aviralverma-8877/esp32-ioptron_smart_eq_controller/ESP32-EasyEDA/20261004_115152.jpg

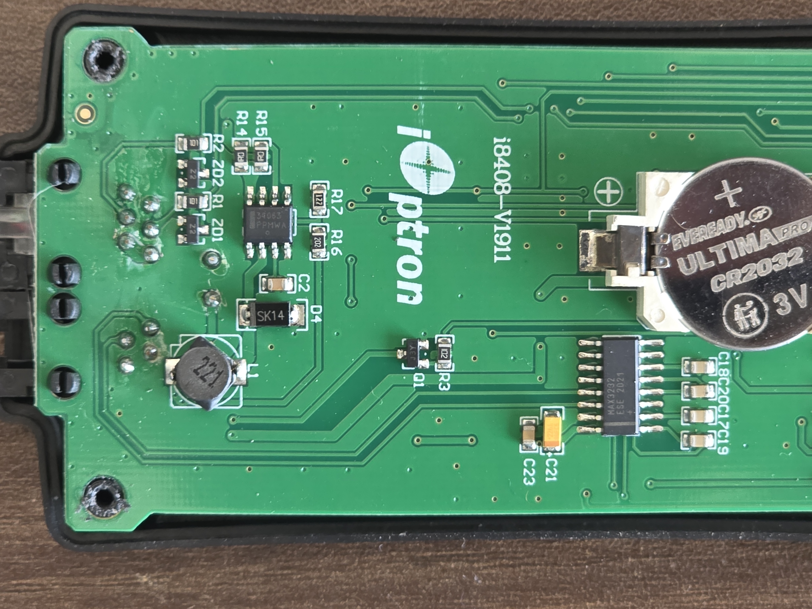
ESP32-EasyEDA/20261004_115152.jpg
