aviralverma-8877/esp32-ioptron_smart_eq_controller/tools/sdcard/catalog.csv

# SmartEQ sky catalog v1 - key | label | name | type | con | mag | size_arcmin | ra_hours_j2000 | dec_deg_j2000
M001 | M1 | Crab Nebula | SN remnant | Tau | 8.4 | 8.0 | 5.575547 | 22.01447
M002 | M2 | NGC 7089 | Globular | Aqr | 6.2 | 8.4 | 21.557503 | -0.82331
M003 | M3 | NGC 5272 | Globular | CVn | 6.4 | 16.2 | 13.703119 | 28.37544
M004 | M4 | NGC 6121 | Globular | Sco | 5.4 | 28.2 | 16.393167 | -26.52553
M005 | M5 | NGC 5904 | Globular | Se1 | 6.0 | 15.0 | 15.309375 | 2.08269
M006 | M6 | Butterfly Cluster | Open cl. | Sco | 4.2 | 15.6 | 17.672431 | -32.25417
M007 | M7 | Ptolemy's Cluster | Open cl. | Sco | 3.3 | 22.2 | 17.897550 | -34.79283
M008 | M8 | Lagoon Nebula | Nebula | Sgr | 5.8 | 45.0 | 18.061464 | -24.38017
M009 | M9 | NGC 6333 | Globular | Oph | 8.4 | 6.9 | 17.319939 | -18.51625
M010 | M10 | NGC 6254 | Globular | Oph | 5.0 | 9.3 | 16.952497 | -4.09933
M011 | M11 | Amas de l'Ecu de Sobieski | Open cl. | Sct | 5.8 | 9.0 | 18.851664 | -6.27003
M012 | M12 | NGC 6218 | Globular | Oph | 6.1 | 11.1 | 16.787367 | -1.94783
M013 | M13 | Hercules Globular Cluster | Globular | Her | 5.8 | 16.5 | 16.694897 | 36.46131
M014 | M14 | NGC 6402 | Globular | Oph | 5.7 | 9.9 | 17.626711 | -3.24592
M015 | M15 | NGC 7078 | Globular | Peg | 6.3 | 11.1 | 21.499550 | 12.16683
M016 | M16 | Eagle Nebula | Nebula | Se2 | 6.0 | 120.0 | 18.313381 | -13.80722
M017 | M17 | Checkmark Nebula | Nebula | Sgr | 7.0 | 12.6 | 18.346419 | -16.17153
M018 | M18 | NGC 6613 | Open cl. | Sgr | 6.9 | 6.0 | 18.332914 | -17.10197
M019 | M19 | NGC 6273 | Globular | Oph | 5.6 | 7.5 | 17.043800 | -26.26794
M020 | M20 | Trifid Nebula | Nebula | Sgr | 8.5 | 28.0 | 18.045031 | -22.97189
M021 | M21 | NGC 6531 | Open cl. | Sgr | 5.9 | 6.0 | 18.070403 | -22.49006
M022 | M22 | NGC 6656 | Globular | Sgr | 5.1 | 12.6 | 18.606722 | -23.90342
M023 | M23 | NGC 6494 | Open cl. | Sgr | 5.5 | 16.8 | 17.951325 | -18.98533
M024 | M24 | Small Sgr Star Cloud | Star cloud | Sgr | 4.5 | 120.0 | 18.282256 | -18.51456
M025 | M25 | IC 4725 | Open cl. | Sgr | 4.6 | 14.1 | 18.529658 | -19.11494
M026 | M26 | NGC 6694 | Open cl. | Sct | 8.9 | 6.0 | 18.755183 | -9.38361
M027 | M27 | Dumbbell Nebula | Planetary | Vul | 7.4 | 6.7 | 19.993439 | 22.72103
M028 | M28 | NGC 6626 | Globular | Sgr | 6.9 | 5.1 | 18.409136 | -24.86983
M029 | M29 | NGC 6913 | Open cl. | Cyg | 6.6 | 3.6 | 20.399381 | 38.50767
M030 | M30 | NGC 7099 | Globular | Cap | 7.1 | 9.0 | 21.672783 | -23.17908
M031 | M31 | Andromeda Galaxy | Galaxy | And | 3.4 | 177.8 | 0.712319 | 41.26906
M032 | M32 | NGC 221 | Galaxy | And | 8.1 | 7.7 | 0.711619 | 40.86528
M033 | M33 | Triangulum Galaxy | Galaxy | Tri | 5.8 | 62.1 | 1.564136 | 30.66022
M034 | M34 | NGC 1039 | Open cl. | Per | 5.2 | 22.5 | 2.702056 | 42.74614
M035 | M35 | NGC 2168 | Open cl. | Gem | 5.3 | 24.0 | 6.151406 | 24.33864
M036 | M36 | NGC 1960 | Open cl. | Aur | 6.0 | 7.2 | 5.604928 | 34.14075
M037 | M37 | NGC 2099 | Open cl. | Aur | 5.6 | 11.4 | 5.871764 | 32.55300
M038 | M38 | NGC 1912 | Open cl. | Aur | 6.4 | 9.6 | 5.478469 | 35.85492
M039 | M39 | NGC 7092 | Open cl. | Cyg | 4.6 | 19.5 | 21.530089 | 48.43817
M040 | M40 | Winnecke 4 | Double | UMa | 8.0 |  | 12.371139 | 58.08444
M041 | M41 | NGC 2287 | Open cl. | CMa | 4.5 | 12.0 | 6.766650 | -20.75422
M042 | M42 | Great Orion Nebula | Cl+Nebula | Ori | 4.0 | 90.0 | 5.587911 | -5.38967
M043 | M43 | Mairan's Nebula | Nebula | Ori | 9.0 | 20.0 | 5.592050 | -5.26747
M044 | M44 | Beehive | Open cl. | Cnc | 3.1 | 108.6 | 8.672833 | 19.67206
M045 | M45 | Pleiades | Open cl. | Tau | 1.2 | 150.0 | 3.791278 | 24.10528
M046 | M46 | NGC 2437 | Open cl. | Pup | 6.1 | 21.0 | 7.696339 | -14.81000
M047 | M47 | NGC 2422 | Open cl. | Pup | 4.4 | 19.8 | 7.609728 | -14.48261
M048 | M48 | NGC 2548 | Open cl. | Hya | 5.8 | 28.2 | 8.228661 | -5.75044
M049 | M49 | NGC 4472 | Galaxy | Vir | 8.3 | 10.2 | 12.496322 | 8.00047
M050 | M50 | NGC 2323 | Open cl. | Mon | 5.9 | 14.1 | 7.044575 | -8.36403
M051 | M51 | Whirlpool Galaxy | Galaxy | CVn | 8.4 | 13.7 | 13.497975 | 47.19517
M052 | M52 | NGC 7654 | Open cl. | Cas | 6.9 | 9.9 | 23.413444 | 61.59317
M053 | M53 | NGC 5024 | Globular | Com | 7.8 | 9.0 | 13.215342 | 18.16911
M054 | M54 | NGC 6715 | Globular | Sgr | 7.7 | 5.1 | 18.917575 | -30.47850
M055 | M55 | NGC 6809 | Globular | Sgr | 6.5 | 12.0 | 19.666500 | -30.96208
M056 | M56 | NGC 6779 | Globular | Lyr | 8.4 | 5.8 | 19.276531 | 30.18450
M057 | M57 | Ring Nebula | Planetary | Lyr | 8.8 | 1.3 | 18.893058 | 33.02858
M058 | M58 | NGC 4579 | Galaxy | Vir | 10.3 | 5.0 | 12.628756 | 11.81819
M059 | M59 | NGC 4621 | Galaxy | Vir | 9.6 | 4.5 | 12.700622 | 11.64703
M060 | M60 | NGC 4649 | Galaxy | Vir | 8.8 | 6.8 | 12.727772 | 11.55269
M061 | M61 | NGC 4303 | Galaxy | Vir | 10.2 | 6.9 | 12.365250 | 4.47364
M062 | M62 | NGC 6266 | Globular | Oph | 6.5 | 7.8 | 17.020167 | -30.11236
M063 | M63 | Sunflower Galaxy | Galaxy | CVn | 8.6 | 11.8 | 13.263703 | 42.02928
M064 | M64 | Black Eye Galaxy | Galaxy | Com | 8.5 | 10.5 | 12.945456 | 21.68297
M065 | M65 | NGC 3623 | Galaxy | Leo | 9.3 | 7.6 | 11.315533 | 13.09236
M066 | M66 | NGC 3627 | Galaxy | Leo | 8.9 | 10.3 | 11.337489 | 12.99153
M067 | M67 | NGC 2682 | Open cl. | Cnc | 6.9 | 33.0 | 8.855592 | 11.81194
M068 | M68 | NGC 4590 | Globular | Hya | 8.0 | 6.6 | 12.657781 | -26.74303
M069 | M69 | NGC 6637 | Globular | Sgr | 7.6 | 5.7 | 18.523119 | -32.34797
M070 | M70 | NGC 6681 | Globular | Sgr | 7.9 | 6.6 | 18.720178 | -32.29189
M071 | M71 | NGC 6838 | Globular | Sge | 8.2 | 6.9 | 19.896142 | 18.77839
M072 | M72 | NGC 6981 | Globular | Aqr | 9.0 | 4.5 | 20.891086 | -12.53706
M073 | M73 | NGC 6994 | Asterism | Aqr | 8.9 |  | 20.982214 | -12.63550
M074 | M74 | NGC 628 | Galaxy | Psc | 9.3 | 9.9 | 1.611597 | 15.78367
M075 | M75 | NGC 6864 | Globular | Sgr | 8.3 | 3.6 | 20.101344 | -21.92222
M076 | M76 | Barbell Nebula | Planetary | Per | 10.1 | 1.1 | 1.705469 | 51.57547
M077 | M77 | NGC 1068 | Galaxy | Cet | 9.3 | 6.1 | 2.711308 | -0.01328
M078 | M78 | NGC 2068 | Nebula | Ori | 8.0 | 4.5 | 5.779394 | 0.07931
M079 | M79 | NGC 1904 | Globular | Lep | 8.2 | 7.2 | 5.402942 | -24.52422
M080 | M80 | NGC 6093 | Globular | Sco | 7.3 | 5.7 | 16.284031 | -22.97511
M081 | M81 | Bode's Galaxy | Galaxy | UMa | 6.9 | 21.6 | 9.925881 | 69.06531
M082 | M82 | Cigar Galaxy | Galaxy | UMa | 8.3 | 11.0 | 9.931314 | 69.67939
M083 | M83 | Southern Pinwheel Galaxy | Galaxy | Hya | 7.2 | 13.6 | 13.616931 | -29.86542
M084 | M84 | NGC 4374 | Galaxy | Vir | 9.8 | 7.4 | 12.417706 | 12.88697
M085 | M85 | NGC 4382 | Galaxy | Com | 9.1 | 7.0 | 12.423364 | 18.19150
M086 | M86 | NGC 4406 | Galaxy | Vir | 8.9 | 11.5 | 12.436594 | 12.94622
M087 | M87 | Virgo Galaxy | Galaxy | Vir | 9.0 | 7.1 | 12.513728 | 12.39111
M088 | M88 | NGC 4501 | Galaxy | Com | 10.3 | 8.7 | 12.533100 | 14.42039
M089 | M89 | NGC 4552 | Galaxy | Vir | 10.1 | 8.1 | 12.594392 | 12.55633
M090 | M90 | NGC 4569 | Galaxy | Vir | 9.5 | 9.1 | 12.613831 | 13.16294
M091 | M91 | NGC 4548 | Galaxy | Com | 11.0 | 5.5 | 12.590681 | 14.49633
M092 | M92 | NGC 6341 | Globular | Her | 6.5 | 14.4 | 17.285353 | 43.13653
M093 | M93 | NGC 2447 | Open cl. | Pup | 6.2 | 15.0 | 7.741453 | -23.85308
M094 | M94 | NGC 4736 | Galaxy | CVn | 8.2 | 7.7 | 12.848072 | 41.12044
M095 | M95 | NGC 3351 | Galaxy | Leo | 9.8 | 7.2 | 10.732694 | 11.70381
M096 | M96 | NGC 3368 | Galaxy | Leo | 9.2 | 8.3 | 10.779372 | 11.81994
M097 | M97 | Owl Nebula | Planetary | UMa | 9.9 | 3.6 | 11.246586 | 55.01903
M098 | M98 | NGC 4192 | Galaxy | Com | 10.8 | 11.0 | 12.230081 | 14.90033
M099 | M99 | Coma Pinwheel | Galaxy | Com | 9.8 | 5.0 | 12.313778 | 14.41650
M100 | M100 | NGC 4321 | Galaxy | Com | 9.5 | 6.1 | 12.381897 | 15.82181
M101 | M101 | NGC 5457 | Galaxy | UMa | 7.9 | 24.0 | 14.053483 | 54.34894
M102 | M102 | Spindle Galaxy | Galaxy | Dra | 9.9 | 6.3 | 15.108194 | 55.76322
M103 | M103 | NGC 581 | Open cl. | Cas | 7.4 | 4.5 | 1.556058 | 60.65800
M104 | M104 | Sombrero Galaxy | Galaxy | Vir | 8.6 | 8.4 | 12.666508 | -11.62306
M105 | M105 | NGC 3379 | Galaxy | Leo | 9.3 | 4.9 | 10.797108 | 12.58161
M106 | M106 | NGC 4258 | Galaxy | CVn | 9.3 | 17.0 | 12.315972 | 47.30397
M107 | M107 | NGC 6171 | Globular | Oph | 7.9 | 7.8 | 16.542200 | -13.05364
M108 | M108 | NGC 3556 | Galaxy | UMa | 10.1 | 4.0 | 11.191936 | 55.67411
M109 | M109 | NGC 3992 | Galaxy | UMa | 9.9 | 8.1 | 11.959994 | 53.37453
M110 | M110 | NGC 205 | Galaxy | And | 8.2 | 16.2 | 0.672800 | 41.68531
S001 | Sirius | alf CMa | Star | CMa | -1.46 |  | 6.752197 | -16.72512
S002 | Canopus | alf Car | Star | Car | -0.74 |  | 6.399213 | -52.69549
S003 | Arcturus | alf Boo | Star | Boo | -0.05 |  | 14.260452 | 19.16769
S004 | Vega | alf Lyr | Star | Lyr | 0.03 |  | 18.615775 | 38.78580
S005 | Capella | alf Aur | Star | Aur | 0.08 |  | 5.278208 | 45.99485
S006 | Rigel | bet Ori | Star | Ori | 0.13 |  | 5.242298 | -8.20163
S007 | Procyon | alf CMi | Star | CMi | 0.34 |  | 7.654681 | 5.21736
S008 | Achernar | alf Eri | Star | Eri | 0.46 |  | 1.628647 | -57.23703
S009 | Betelgeuse | alf Ori | Star | Ori | 0.50 |  | 5.919543 | 7.40715
S010 | Hadar | bet Cen | Star | Cen | 0.61 |  | 14.063691 | -60.37321
S011 | Altair | alf Aql | Star | Aql | 0.76 |  | 19.846655 | 8.87116
S012 | Acrux | alf Cru | Star | Cru | 0.76 |  | 12.443265 | -63.09920
S013 | Aldebaran | alf Tau | Star | Tau | 0.86 |  | 4.598710 | 16.50791
S014 | Antares | alf Sco | Star | Sco | 0.96 |  | 16.490121 | -26.43217
S015 | Spica | alf Vir | Star | Vir | 0.97 |  | 13.419862 | -11.16155
S016 | Pollux | bet Gem | Star | Gem | 1.14 |  | 7.754916 | 28.02586
S017 | Fomalhaut | alf PsA | Star | PsA | 1.16 |  | 22.961032 | -29.62345
S018 | Deneb | alf Cyg | Star | Cyg | 1.25 |  | 20.690533 | 45.28035
S019 | Mimosa | bet Cru | Star | Cru | 1.25 |  | 12.795311 | -59.68889
S020 | Regulus | alf Leo | Star | Leo | 1.35 |  | 10.139406 | 11.96725
S021 | Adhara | eps CMa | Star | CMa | 1.50 |  | 6.977099 | -28.97208
S022 | Castor | alf Gem | Star | Gem | 1.58 |  | 7.576521 | 31.88721
S023 | Shaula | lam Sco | Star | Sco | 1.62 |  | 17.560139 | -37.10405
S024 | Gacrux | gam Cru | Star | Cru | 1.64 |  | 12.519459 | -57.11516
S025 | Bellatrix | gam Ori | Star | Ori | 1.64 |  | 5.418847 | 6.34961
S026 | Elnath | bet Tau | Star | Tau | 1.65 |  | 5.438211 | 28.60617
S027 | Miaplacidus | bet Car | Star | Car | 1.67 |  | 9.219772 | -69.71641
S028 | Alnilam | eps Ori | Star | Ori | 1.69 |  | 5.603560 | -1.20192
S029 | Alnair | alf Gru | Star | Gru | 1.73 |  | 22.137309 | -46.96206
S030 | Alnitak | zet Ori | Star | Ori | 1.77 |  | 5.679315 | -1.94256
S031 | Alioth | eps UMa | Star | UMa | 1.77 |  | 12.900584 | 55.95976
S032 | Dubhe | alf UMa | Star | UMa | 1.79 |  | 11.061992 | 61.75078
S033 | Mirfak | alf Per | Star | Per | 1.79 |  | 3.405399 | 49.86099
S034 | Wezen | del CMa | Star | CMa | 1.83 |  | 7.139855 | -26.39318
S035 | Kaus Australis | eps Sgr | Star | Sgr | 1.85 |  | 18.402843 | -34.38553
S036 | Alkaid | eta UMa | Star | UMa | 1.86 |  | 13.792253 | 49.31316
S037 | Sargas | the Sco | Star | Sco | 1.86 |  | 17.621984 | -42.99785
S038 | Menkalinan | bet Aur | Star | Aur | 1.90 |  | 5.992106 | 44.94743
S039 | Atria | alf TrA | Star | TrA | 1.91 |  | 16.811107 | -69.02794
S040 | Alhena | gam Gem | Star | Gem | 1.93 |  | 6.628538 | 16.39888
S041 | Peacock | alf Pav | Star | Pav | 1.94 |  | 20.427466 | -56.73572
S042 | Polaris | alf UMi | Star | UMi | 1.98 |  | 2.532004 | 89.26402
S043 | Mirzam | bet CMa | Star | CMa | 1.98 |  | 6.378328 | -17.95592
S044 | Alphard | alf Hya | Star | Hya | 1.98 |  | 9.459782 | -8.65835
S045 | Hamal | alf Ari | Star | Ari | 2.00 |  | 2.119658 | 23.46133
S046 | Algieba | gam Leo | Star | Leo | 2.01 |  | 10.333034 | 19.84035
S047 | Diphda | bet Cet | Star | Cet | 2.02 |  | 0.726612 | -17.98637
S048 | Nunki | sig Sgr | Star | Sgr | 2.05 |  | 18.921099 | -26.29712
S049 | Mirach | bet And | Star | And | 2.05 |  | 1.162307 | 35.61973
S050 | Alpheratz | alf And | Star | And | 2.06 |  | 0.139872 | 29.08923
S051 | Rasalhague | alf Oph | Star | Oph | 2.07 |  | 17.582296 | 12.55841
S052 | Kochab | bet UMi | Star | UMi | 2.08 |  | 14.845032 | 74.15559
S053 | Saiph | kap Ori | Star | Ori | 2.09 |  | 5.795942 | -9.66961
S054 | Almach | gam And | Star | And | 2.10 |  | 2.065015 | 42.32937
S055 | Algol | bet Per | Star | Per | 2.12 |  | 3.136150 | 40.95563
S056 | Denebola | bet Leo | Star | Leo | 2.13 |  | 11.817408 | 14.57121
S057 | Mizar | zet UMa | Star | UMa | 2.23 |  | 13.398863 | 54.92516
S058 | Schedar | alf Cas | Star | Cas | 2.24 |  | 0.675167 | 56.53710
S059 | Caph | bet Cas | Star | Cas | 2.28 |  | 0.153469 | 59.14846
S060 | Albireo | bet Cyg | Star | Cyg | 3.05 |  | 19.512024 | 27.95959
P001 | Mercury | Innermost planet | Planet |  | 0.0
P002 | Venus | Evening/morning star | Planet |  | -4.2
P003 | Mars | The red planet | Planet |  | 0.5
P004 | Jupiter | Gas giant | Planet |  | -2.3
P005 | Saturn | Ringed planet | Planet |  | 0.6
P006 | Uranus | Ice giant | Planet |  | 5.7
P007 | Neptune | Ice giant | Planet |  | 7.8
P008 | Moon | Earth's Moon | Moon |  | -12.7
