aviralverma-8877/esp32-ioptron_smart_eq_controller/cad-shell/Top (With SD Card).stl

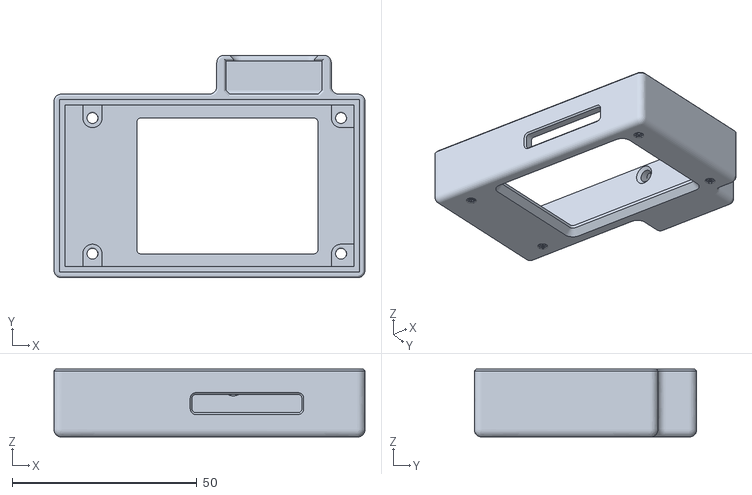
[picture p2: CAD file, 2026-10-21]
cad-shell/Top (With SD Card).stl
84.2 x 60.2 x 18.4
