aviralverma-8877/esp32-ioptron_smart_eq_controller/cad-shell/Bottom.stl

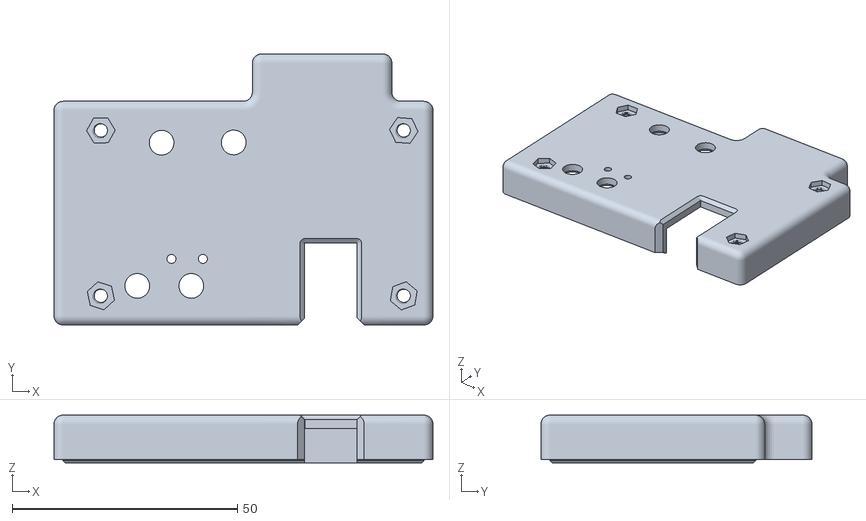
[picture p3: CAD file, 2026-10-21]
cad-shell/Bottom.stl
84.2 x 60.2 x 10.6
