aviralverma-8877/esp32-ioptron_smart_eq_controller/cad-shell/Buttons.stl

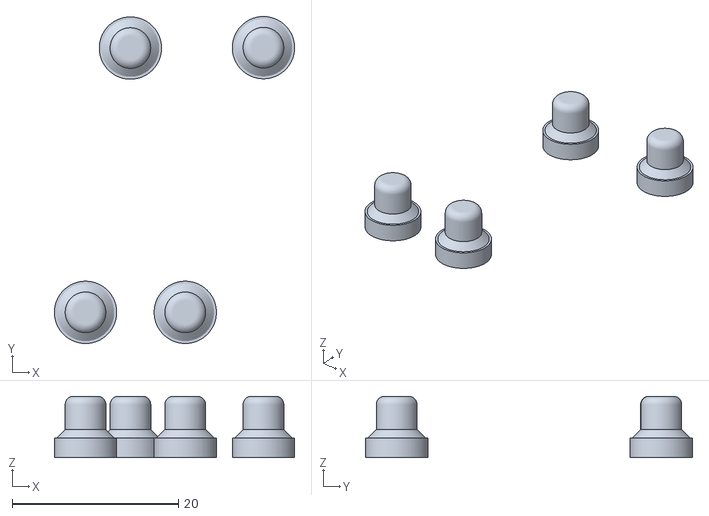
[picture p4: CAD file, 2026-10-17]
cad-shell/Buttons.stl
28.9 x 39.3 x 7.40
