aviralverma-8877/esp32-ioptron_smart_eq_controller/(list of files, cad)

Other CAD files:
cad-shell/Top.stl
