aviralverma-8877/esp32-ioptron_smart_eq_controller/src/display.cpp

// display.cpp - ST7789 status page (mount / GPS / SD). Redraws only changed fields;
// ui.cpp owns the screen and calls displayTick() only while this page is shown.
#include "display.h"
#include "config.h"
#include "mount.h"
#include "bt_bridge.h"
#include "gps.h"
#include "gps_sync.h"
#include "message.h"
#include "sky.h"
#include "xlate.h"
#include <SPI.h>
#include <esp32/rom/crc.h>
#include <Adafruit_GFX.h>
#include <Adafruit_ST7789.h>
#include <string.h>

Adafruit_ST7789 tft(TFT_CS, TFT_DC, TFT_RST);
static const int SCR_W = 320;

struct Row { int16_t y; uint8_t sz; const char *label; char cache[34]; };
static Row rows[] = {
  {  30, 1, "Model", "" }, {  42, 1, "FW",    "" },
  {  56, 2, "Time",  "" }, {  78, 2, "Date",  "" },
  { 100, 1, "Zone",  "" }, { 112, 2, "Site",  "" },
  { 136, 2, "Stat",  "" }, { 158, 1, "Trk",   "" }, { 170, 1, "Pos", "" },
};
enum { R_MODEL, R_FW, R_TIME, R_DATE, R_ZONE, R_SITE, R_STAT, R_TRK, R_POS };
static char hdrCache[48] = "", gpsCache[40] = "", fixCache[40] = "", ftrCache[40] = "";

static void txt(int x, int y, const char *s, uint16_t fg, uint8_t sz, uint16_t bg = BG) {
  tft.setTextSize(sz); tft.setTextColor(fg, bg); tft.setCursor(x, y); tft.print(s);
}

static void staticLayout() {
  tft.fillScreen(BG);
  tft.drawFastHLine(0, 26, SCR_W, C_HEAD);
  tft.drawFastHLine(0, 52, SCR_W, C_SEP);
  tft.drawFastHLine(0, 132, SCR_W, C_SEP);
  tft.drawFastHLine(0, 186, SCR_W, C_SEP);
  for (auto &r : rows) txt(4, r.y + (r.sz == 2 ? 2 : 0), r.label, C_LBL, 1);
}

static void row(int i, const char *val, uint16_t color) {
  Row &r = rows[i];
  int w = r.sz == 2 ? 13 : 8;                 // pad width in chars
  char pad[40];
  snprintf(pad, sizeof pad, "%-*.*s", 26 - w, 26 - w, val);
  if (!strcmp(r.cache, pad)) return;
  strncpy(r.cache, pad, sizeof r.cache - 1);
  txt(w * 6 + 6, r.y, pad, color, r.sz);
}

static void header() {
  const char *st0 = btConnected ? "BRIDGE" : (linkUp ? "MOUNT OK" : "NO MOUNT");
  char st[24];
  if (xlateMode() == XL_NATIVE) snprintf(st, sizeof st, "%s", st0);
  else snprintf(st, sizeof st, "%s  %s", st0, xlateModeName(xlateMode()));   // BT client protocol
  bool sd = skyReady();
  char h[48];
  snprintf(h, sizeof h, "%s|%s|%d", BT_NAME, st, sd);
  if (strcmp(h, hdrCache)) {
    strncpy(hdrCache, h, sizeof hdrCache - 1);
    tft.fillRect(0, 2, SCR_W, 22, BG);
    txt(4, 4, BT_NAME, C_HEAD, 2);
    txt(4 + 12 * 12, 8, st, btConnected ? C_WARN : (linkUp ? C_OK : C_BAD), 1);
    if (sd) {                                  // catalog badge ("SD" / "FS")
      tft.fillRoundRect(SCR_W - 26, 5, 22, 15, 3, C_OK);
      txt(SCR_W - 21, 9, SKY_BADGE, BG, 1, C_OK);
    }
  }
}

static void gpsBlock() {
  char s[40], line[40];
  gpsStatusStr(s, sizeof s);
  bool lk = gpsLocked();
  snprintf(line, sizeof line, "GPS: %-18s", s);
  if (strcmp(line, gpsCache)) {
    strncpy(gpsCache, line, sizeof gpsCache - 1);
    tft.fillRect(0, 192, SCR_W, 18, BG);
    txt(4, 192, "GPS:", C_LBL, 2);
    txt(4 + 5 * 12, 192, s, lk ? C_OK : C_WARN, 2);
  }
  char d[40];
  snprintf(d, sizeof d, "%-38s", syncMsg);
  if (strcmp(d, fixCache)) {
    strncpy(fixCache, d, sizeof fixCache - 1);
    tft.fillRect(0, 212, SCR_W, 10, BG);
    txt(4, 212, syncMsg, syncMsgColor, 1);
  }
}

static void footer() {
  char f[40];
  if (millis() < gMsgUntil) {
    snprintf(f, sizeof f, "%-38s", gMsg);
    if (strcmp(f, ftrCache)) {
      strncpy(ftrCache, f, sizeof ftrCache - 1);
      tft.fillRect(0, 228, SCR_W, 12, BG);
      txt(4, 229, gMsg, gMsgColor, 1);
    }
    return;
  }
  if (skyReady())       snprintf(f, sizeof f, "BOOT: sky catalog");
  else if (!M.everOk)   snprintf(f, sizeof f, "waiting for mount...        ");
  else if (btConnected) snprintf(f, sizeof f, "bridging - values held      ");
  else snprintf(f, sizeof f, "mount src:%s  upd %lus       ",
                M.gpsSrc[0] ? M.gpsSrc : "?", (millis() - M.lastOkMs) / 1000);
  if (strcmp(f, ftrCache)) {
    strncpy(ftrCache, f, sizeof ftrCache - 1);
    tft.fillRect(0, 228, SCR_W, 12, BG);
    txt(4, 229, f, C_LBL, 1);
  }
}

static void render() {
  char b[48];
  header();

  snprintf(b, sizeof b, "%s (%s)", M.modelName[0] ? M.modelName : "-", M.model);
  row(R_MODEL, b, C_VAL);
  snprintf(b, sizeof b, "%s %s/%s", M.proto[0] ? M.proto : "-",
           M.fwMain[0] ? M.fwMain : "-", M.fwMotor[0] ? M.fwMotor : "-");
  row(R_FW, b, C_VAL);

  row(R_TIME, M.timeStr[0] ? M.timeStr : "--:--:--", C_VAL);
  row(R_DATE, M.dateStr[0] ? M.dateStr : "----------", C_VAL);
  snprintf(b, sizeof b, "UTC%s  DST %s", M.utcOffset[0] ? M.utcOffset : "?",
           M.dst[0] ? M.dst : "?");
  row(R_ZONE, b, C_VAL);
  snprintf(b, sizeof b, "%s %s", M.lonStr[0] ? M.lonStr : "lon?",
           M.latStr[0] ? M.latStr : "lat?");
  row(R_SITE, b, C_VAL);

  bool moving = !strcmp(M.statusStr, "Slewing") || !strcmp(M.statusStr, "Guiding");
  snprintf(b, sizeof b, "%s  %s", M.statusStr[0] ? M.statusStr : "-",
           M.slewRate[0] ? M.slewRate : "?");
  row(R_STAT, b, moving ? C_WARN : C_VAL);
  snprintf(b, sizeof b, "%s g%s", M.trackStr[0] ? M.trackStr : "-",
           M.guideStr[0] ? M.guideStr : "?");
  row(R_TRK, b, C_VAL);
  snprintf(b, sizeof b, "RA %s Dec %s", M.raStr[0] ? M.raStr : "--h--m", M.decStr);
  row(R_POS, b, C_VAL);

  gpsBlock();
  footer();
}

void displayBegin() {
  tft.init(240, 320);
  tft.setSPISpeed(TFT_HZ);
  tft.invertDisplay(TFT_INVERT);
  tft.setRotation(1);              // 320x240 landscape
  tft.cp437(true);                 // correct CP437 table: 0xF8 = degree sign
  tft.setTextWrap(false);
  LOG("[tft] %d x %d\n", tft.width(), tft.height());
  staticLayout();
  header();
  footer();
}

void displayStatusEnter() {
  for (auto &r : rows) r.cache[0] = 0;
  hdrCache[0] = gpsCache[0] = fixCache[0] = ftrCache[0] = 0;
  staticLayout();
  render();
}

// Screenshot over the USB console: read the panel's own RAM back (RAMRD, 18-bit
// pixels, one burst for the whole screen), print each row run-length encoded
// as RGB565 hex:
//   SHOT 320 240 [D] / R<y> <rgb565>[*<count>] ... / SHOTEND <millis>
// tools/tftshot.py turns that into a PNG. Delta (D): only rows that changed
// since the previous shot are sent - fast enough to film the UI ("baud 921600").
// The read starts with one dummy byte; needs the LCD's SDO wired to MISO.
void displayShot(bool delta, uint32_t hz) {
  const int W = 320, H = 240;
  static uint8_t row[W * 3];
  static uint32_t rowCrc[H];
  Serial.printf("\nSHOT %d %d%s\n", W, H, delta ? " D" : "");
  tft.startWrite();
  tft.setAddrWindow(0, 0, W, H);
  tft.endWrite();
  SPI.beginTransaction(SPISettings(hz, MSBFIRST, SPI_MODE0));
  digitalWrite(TFT_CS, LOW);
  digitalWrite(TFT_DC, LOW);
  SPI.transfer(0x2E);                              // RAMRD
  digitalWrite(TFT_DC, HIGH);
  SPI.transfer(0);                                 // dummy byte
  for (int y = 0; y < H; y++) {
    memset(row, 0, sizeof row);
    SPI.transfer(row, sizeof row);                 // the panel keeps streaming between rows
    uint32_t crc = crc32_le(0, row, sizeof row);
    if (delta && crc == rowCrc[y]) continue;
    rowCrc[y] = crc;
    Serial.printf("R%d", y);
    uint16_t run = 0; int cnt = 0;
    for (int x = 0; x <= W; x++) {
      uint16_t c = 0;
      if (x < W) {
        const uint8_t *p = row + x * 3;
        c = (p[0] & 0xF8) << 8 | (p[1] & 0xFC) << 3 | p[2] >> 3;
      }
      if (x < W && cnt && c == run) { cnt++; continue; }
      if (cnt) { if (cnt > 1) Serial.printf(" %04x*%d", run, cnt); else Serial.printf(" %04x", run); }
      run = c; cnt = 1;
    }
    Serial.print('\n');
  }
  digitalWrite(TFT_CS, HIGH);
  SPI.endTransaction();
  Serial.printf("SHOTEND %lu\n", (unsigned long)millis());
}

void displayTick() {
  static uint32_t t = 0;
  if (millis() - t < 250) return;
  t = millis();
  render();
}
