aviralverma-8877/esp32-ioptron_smart_eq_controller/(commit log)

2026-09-07 ESP32 iOptron SmartEQ controller: BT-SPP <-> RS-232 bridge, status TFT, auto GPS sync
    - Classic Bluetooth SPP <-> MAX3232/RJ9 transparent byte bridge (9600 8N1)
    - ST7789 320x240 status screen: model, firmware, time, UTC/DST, site, RA/Dec,
    tracking + guide rate, mount status; redraws only changed fields
    - Polls the mount when no BT client is connected; goes fully transparent when one is
    - Automatic GPS -> mount time + site sync (NEO-6M on GPIO32) once a fix is stable,
    re-syncs every 3 h; deferred while a BT client is connected; optional BTN1 re-sync
    - LED2 (GPIO2) = mount-link indicator, follows RJ9 link state
    - iOptron V1.00 legacy command set decoders (:GLT/:GLS/:GAS/:GEC/:AG/:FW/:Mount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
    [main.cpp]
2026-09-07 Split firmware into modules; add browser web-flasher
    Refactor the ~685-line main.cpp into focused units:
    config.h message mount bt_bridge gps gps_sync display + thin main.cpp
    Behaviour is unchanged (verified on hardware: mount poll/decode, BT bridge
    transparency, GPS auto-sync state machine, LED2 link indicator).
    Web flasher (docs/, GitHub Pages -> /docs):
    - docs/index.html ESP Web Tools install page (Chrome/Edge Web Serial)
    - docs/manifest.json + docs/firmware/smarteq-rj9-merged.bin (flash @ 0x0)
    - scripts/merge_bin.py post-build hook: regenerates the merged image and
    bumps the manifest version on every `pio run`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
2026-10-17 Add SD-card sky catalog with object browser and GoTo/track UI
    - SD card on the LCD module (CS GPIO33) holds 110 Messier objects + 60 bright
    stars: 96x96 DSS2 thumbnails, description, suggested scope/camera/exposure
    - Two-button UI: status -> menu -> object list (live altitude) -> object page
    with TRACK; TRACK enabled only >= 10 deg above the horizon
    - GoTo with on-device J2000->JNow precession: :ST1# :Sr :Sd :MS#, any button
    stops (:q#); disabled while a BT client is connected
    - Buttons sampled by a 10 ms esp_timer (no GPIO36/39 interrupts)
    - Fix :GEC# RA decoding (RA is in ms on this mount)
    - tools/sdcard/build_sd.py builds the catalog, images and a 64 MB FAT32
    image (docs/sdcard/sm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
2026-10-17 Add planets/Moon with on-device ephemeris; single/double-press buttons
    - Planets Mercury..Neptune + Moon in the SD catalog (P-keys) with NASA
    thumbnails, descriptions and planetary-imaging advice; positions computed
    on the device (JPL elements / Schlyter perturbations, Meeus ch.47 Moon with
    topocentric parallax), verified vs JPL Horizons to <= ~2 arcmin
    - Sun safety guard: TRACK disabled within 15 deg of the Sun (or if unknown)
    - Buttons: A = next (hold = fast scroll), A twice = select, B = back;
    any button while slewing stops instantly
    - build_sd.py: planet images from Wikimedia Commons, SIMBAD retries
2026-10-17 Pages: add SD card image / files download section
    - docs/index.html: SD-card section with .img and files downloads, flashing
    steps, button guide and credits; sizes/version read from sdcard.json
    - build_sd.py writes docs/sdcard/sdcard.json (version, counts, sizes)
2026-10-17 Update enclosure shell CAD (top, bottom, buttons)
2026-10-18 Three-button navigation (A up, B down, BOOT select/back); go-to-zero menu item
    - Buttons: A (GPIO36) = up, B (GPIO39) = down, both with hold-repeat;
    BOOT (GPIO0) short press = select, long press = back. Replaces the
    single/double-press scheme. Pins renamed BTN_A_PIN / BTN_B_PIN / BTN_SEL_PIN.
    - Menu: "Go to zero position" sends :MH# after a confirming second select;
    any button stops the slew, 4 min timeout, reports "At zero position" on
    status 7.
    - Bluetooth: start Bluedroid first in setup() and log begin() result,
    free heap, BT address and SPP events (pairing debug).
    - Rebuilt web-flasher image.
2026-10-18 Pages: document three-button controls and go-to-zero
2026-10-18 Update enclosure top shell CAD
2026-10-18 Fix GPS site sync units; set time zone; TZ menu; USB mount console
    The SmartEQ Pro (:V# V1.00) takes :St/:Sg latitude/longitude in whole
    arc-seconds (6 digits). We sent 0.01" (8 digits); the mount acked '1' but
    stored a wrapped garbage site (pole altitude -41.9 deg at 13 N), so GoTo
    missed from both this controller and the hand controller. Send arc-seconds,
    decode :Gt#/:Gg# as arc-seconds, and drop the bogus +90 latitude workaround.
    - Sync writes the time zone (:SG) and DST off (:SDS0) before :SC/:SL so the
    mount's UTC is exact; logs :GLT#/:GLS#/:GAC# read-backs.
    - Time zone menu item: Auto (from GPS position) or a fixed offset in
    15-min steps, saved in NVS.
    - A marginal GPS fix no long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
2026-10-18 Keep TRACKING state when returning to the tracked object
    Remember which object the last GoTo targeted; re-entering its page while
    the mount is still tracking shows TRACKING instead of resetting to TRACK.
    The button drops back to TRACK if tracking is stopped elsewhere (menu or
    hand controller), after a 5 s grace for the post-:ST1# poll.
2026-10-18 Bluetooth pairing control, time zone, factory reset; docs for Stellarium
    Bluetooth: the device is no longer discoverable except during a 2-minute
    pairing window opened from Menu -> Bluetooth. Pairing uses SSP numeric
    comparison accepted with BOOT on the controller; bonds stay in NVS with the
    device name, can be listed and forgotten, and only paired devices may open
    the SPP link (checked in the main loop, not inside the Bluedroid callback).
    Menu: Time zone (Auto from GPS position or fixed, 15-min steps, saved in
    NVS), Bluetooth screen, Factory reset (forget bonds + clear settings +
    reboot). The menu now opens without an SD card.
    USB debug console: pair / unpair / accept for the pairing wind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
2026-10-20 LX200 / NexStar protocol translation for Bluetooth clients
    Menu -> Bluetooth -> Protocol (saved in NVS) picks what a Bluetooth client
    speaks: iOptron (byte-transparent, as before, default), Meade LX200 or
    Celestron NexStar. In the translated modes every client command is answered
    by the controller using the iOptron 2014 commands, so Stellarium, SkySafari
    and INDI connect directly with their built-in drivers - no ASCOM/Commander.
    Translated: position (:GR/:GD/:GA/:GZ, E/e/Z/z), GoTo (:Sr/:Sd/:MS, R/r),
    sync (:CM, S/s), stop, slewing status, manual moves + rates, tracking,
    park -> zero position, time/site read-back. Time/site setters are
    acknowledged but not applied (the GPS sync owns them).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
2026-10-20 Fix Android pairing: don't close the window on a stored-key auth
    Android authenticates with its old link key right before it starts a new
    pairing. Any successful ESP_BT_GAP_AUTH_CMPL was treated as "paired", so the
    window closed and the phone's numeric-comparison request 0.3 s later was
    rejected - every Android pairing failed. Now only an auth that completes
    after BOOT accepted that peer's code counts as a new pairing (and closes the
    window); other successful auths are logged as stored-key and no longer flash
    "Paired:" on every reconnect.
    Verified with a Samsung S25 Ultra + Stellarium Mobile (Protocol NexStar):
    pairing, connect, GoTo, direction buttons, stop.
    Docs: pairing troubleshooting,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
2026-10-20 App time/site sync (Stellarium Mobile "Time: correct"), GPS sync fixes
    Translator: time and site sent by the app (NexStar H/W, LX200 :SG :SL :SC
    :St :Sg) are now written to the mount while the GPS has no fix; with a fix
    the GPS stays the authority. Stellarium Mobile showed "Time: incorrect":
    - NexStar carries the UTC offset in whole hours (India +5:30 arrives as +5
    with true local time). The zone written is our Time zone setting (Auto:
    from the site) when the app's offset is within an hour of it - not the
    zone stored in the mount, which an earlier write had left at +5:00.
    - h answers with the local time matching the whole-hour offset (UTC+5:00
    with W=5), so the app's UTC = loca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
2026-10-21 Update enclosure shell CAD; add top variant with SD card slot
2026-10-25 Open Bluetooth (Just Works), TFT debug log, console UI control
    Bluetooth now behaves like a plain serial module: always discoverable,
    SSP Just Works pairing (IO capability NONE), any device may connect. The
    pairing window, numeric-comparison dialog and paired-only check are gone;
    a host whose old bond we lost simply pairs again. The Bluetooth screen
    keeps Protocol and the paired-device list.
    Debugging aids:
    - LOG() also feeds a line ring shown on a new "Debug log" screen
    (menu, or any USB console command; "tft" toggles it).
    - Console "btn a|b|sel|back|a+|b+" injects button presses.
    - Console "shot"/"shotd [hz]" dump the TFT (RAMRD readback, delta rows)
    and "baud <n>" speeds up the conso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
2026-10-25 Docs: Windows pairing, COM-port renumbering, Stellarium steps, debug tools
    - Pairing: separate Android (Stellarium Select -> Pair) and Windows
    (Settings -> Add device) steps; warn that the Outgoing/Incoming COM
    numbers can swap after re-pairing and that the Incoming port freezes
    Stellarium.
    - Stellarium direct: full Telescope Control steps (editable port box,
    Start, F3 / slew window), NexStar as the tested default.
    - Menu tables list the Debug log screen; README gets a console command
    table (btn, shot/shotd, baud, tft, bonds/forget) and the new files.
    - Replace the stale "paired-only" security note with the open-Bluetooth
    behaviour.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
2026-10-27 Add esp32dev-littlefs: sky catalog on-chip, no SD card needed
    New PlatformIO environment reusing the same source, gated by
    -DSKY_STORAGE_LITTLEFS=1: sky.cpp swaps the SD card for LittleFS on internal
    flash (always mounted, no hot-plug), and the UI shows an "FS" badge instead
    of "SD". A custom partitions_littlefs.csv shrinks app0 (3 MB -> 1.5625 MB,
    actual firmware use is ~1.2 MB) to make room for a ~2.3 MB LittleFS data
    partition on a 4 MB flash module.
    tools/littlefs/build_littlefs.py shrinks the committed SD card thumbnails
    (96x96 -> 64x64) to fit that partition, entirely offline (reuses
    docs/sdcard/smarteq-sd-files.zip, no network fetch needed). Centering the
    smaller thumbnail in ui.cpp'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
